ngweibin050-dev/Laundrix/docs/circuit-diagram.png

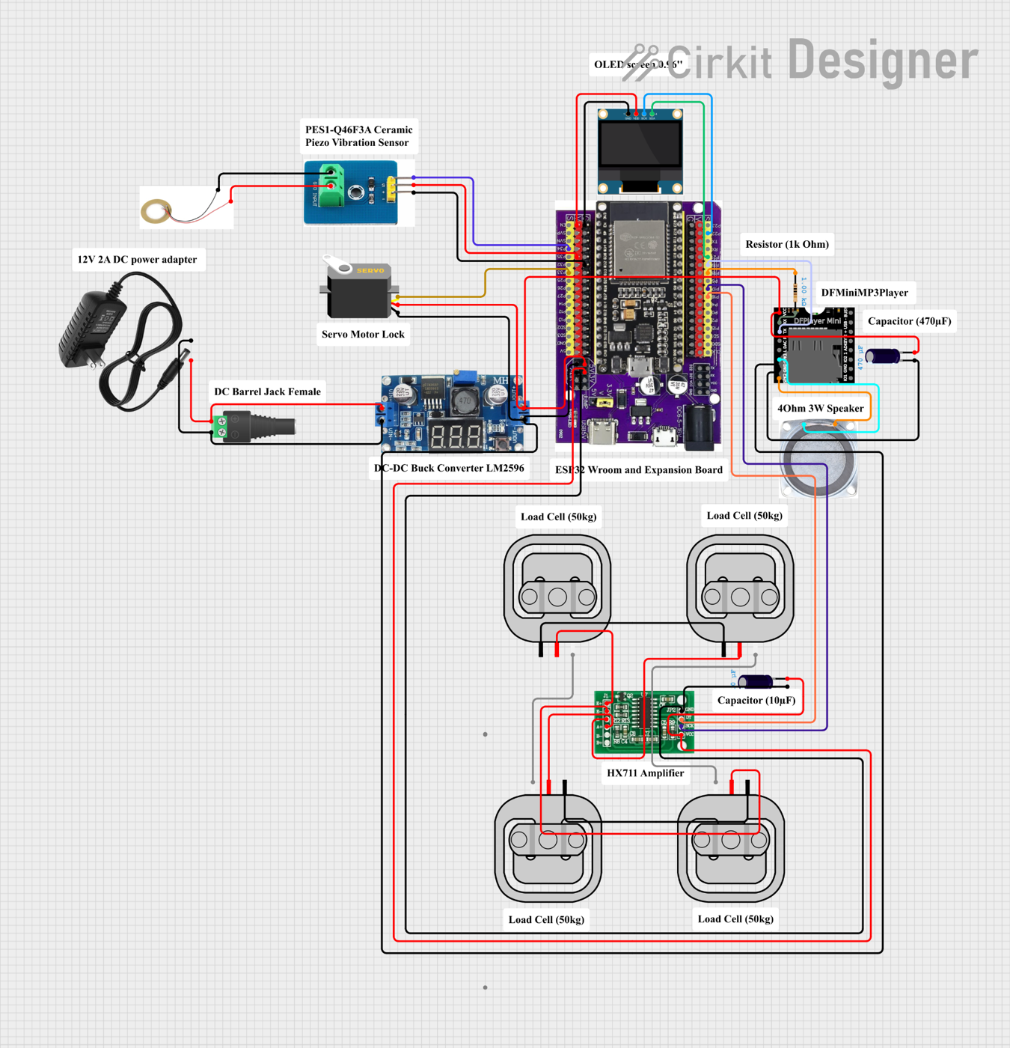
docs/circuit-diagram.png
