ngweibin050-dev/Laundrix/firmware/laundrix_esp32/secrets.example.h

#pragma once
// Copy to secrets.h (git-ignored) and fill in. Never commit secrets.h.
#define SECRET_WIFI_SSID      "your-wifi-ssid"
#define SECRET_WIFI_PASSWORD  "your-wifi-password"
#define SECRET_API_KEY        "your-firebase-web-api-key"
#define SECRET_DATABASE_URL   "https://your-project-default-rtdb.region.firebasedatabase.app"
#define SECRET_USER_EMAIL     "device-account@example.com"
#define SECRET_USER_PASSWORD  "device-account-password"
